vailatis/mqtt_thermostat/sample_pictures/2_Mode.jpg

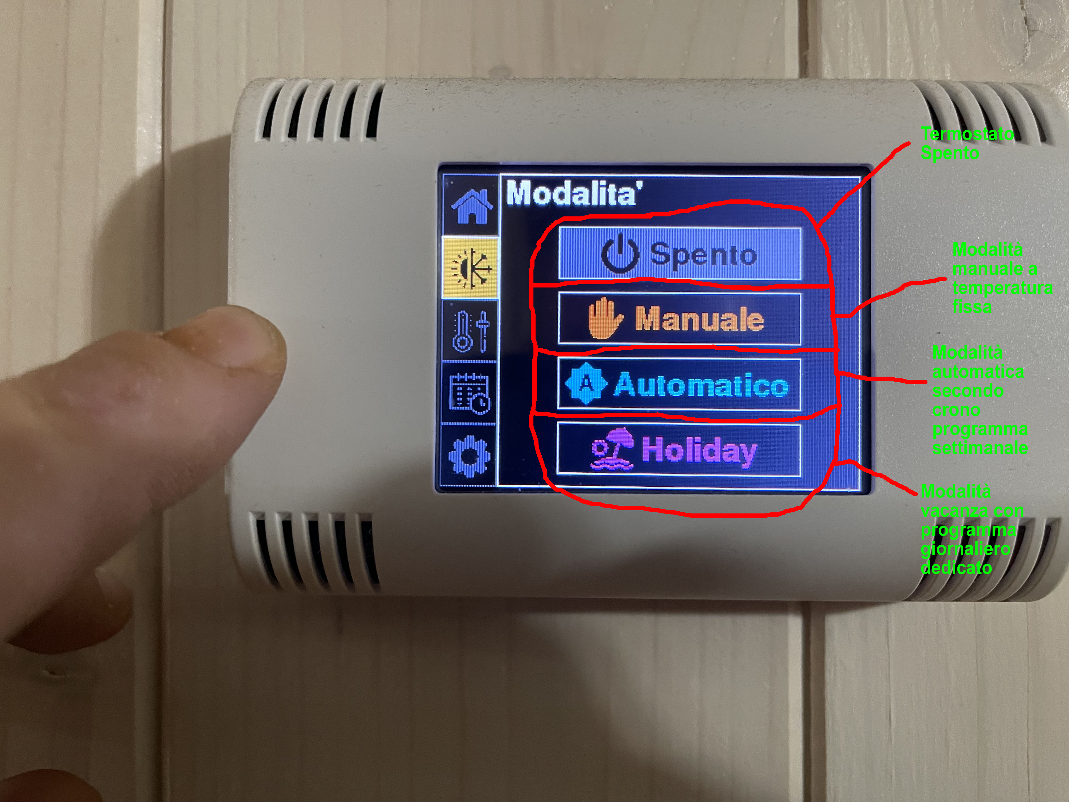
sample_pictures/2_Mode.jpg
