vailatis/mqtt_thermostat/sample_pictures/3_SetPoints.jpg

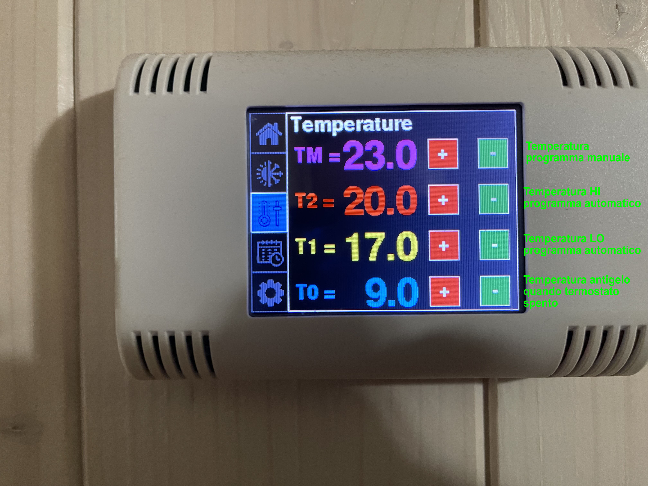
sample_pictures/3_SetPoints.jpg
