vailatis/mqtt_thermostat/sample_pictures/4_Schedule.jpg

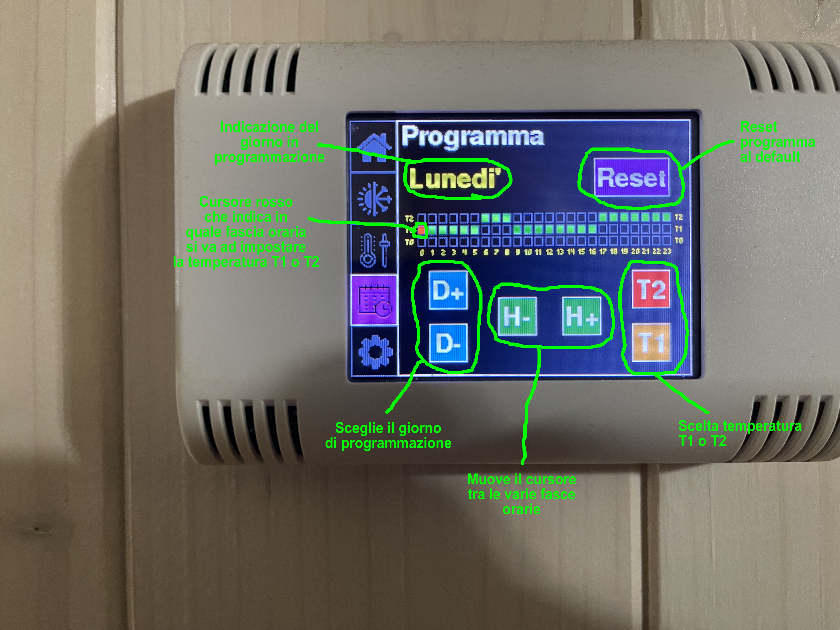
sample_pictures/4_Schedule.jpg
