vailatis/mqtt_thermostat/sample_pictures/5_Settings.jpg

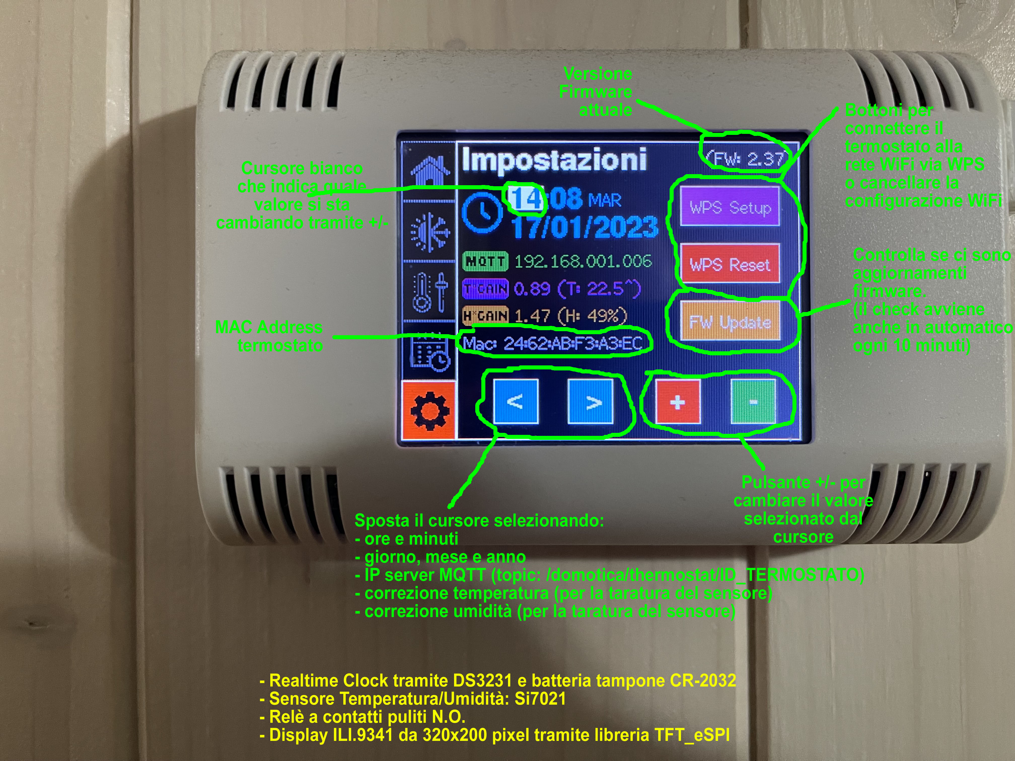
sample_pictures/5_Settings.jpg
