vailatis/mqtt_thermostat/sample_pictures/CS_Frontale.jpg

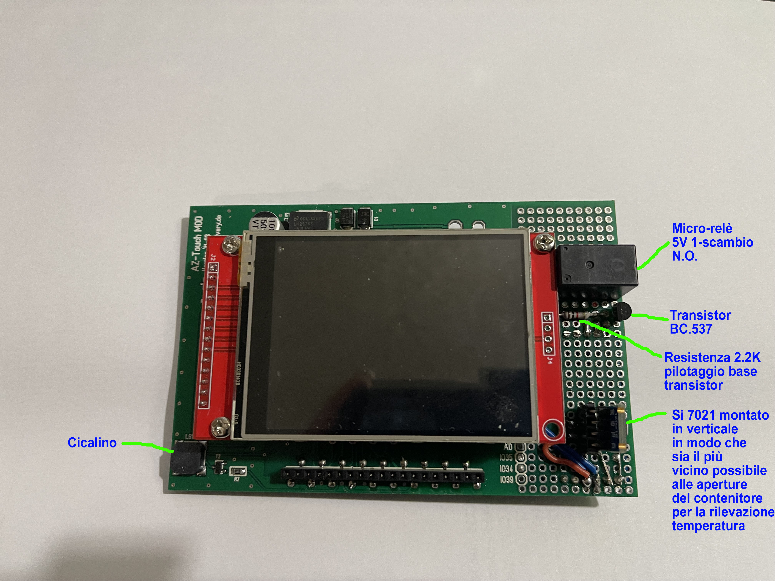
sample_pictures/CS_Frontale.jpg
