vailatis/mqtt_thermostat/sample_pictures/CS_Posteriore.jpg

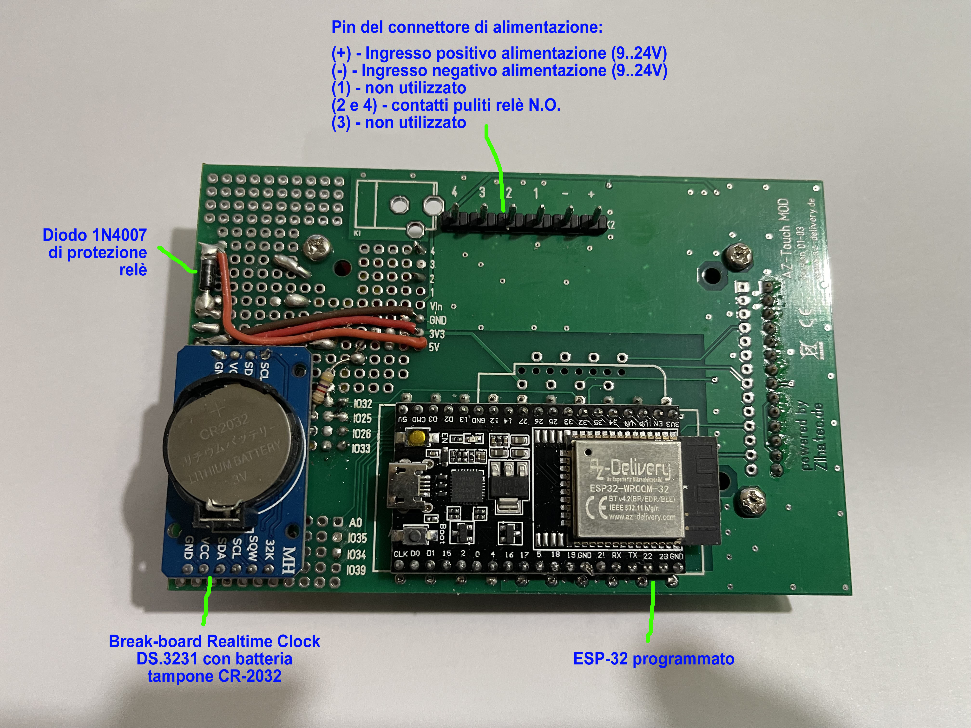
sample_pictures/CS_Posteriore.jpg
