vailatis/mqtt_thermostat/AZ-Touch MOD schematic V01-03-01 (1).pdf

K6 | TFT 2.4 inch / 240x320 GPIO25 GPIO33 GPIO32 GPIO35 GPIO34 GPIO39 A0GPIO26 GND GPIO26 GPIO25 GPIO33 GPIO32 GPIO35 GPIO34 GPIO39

## TxD

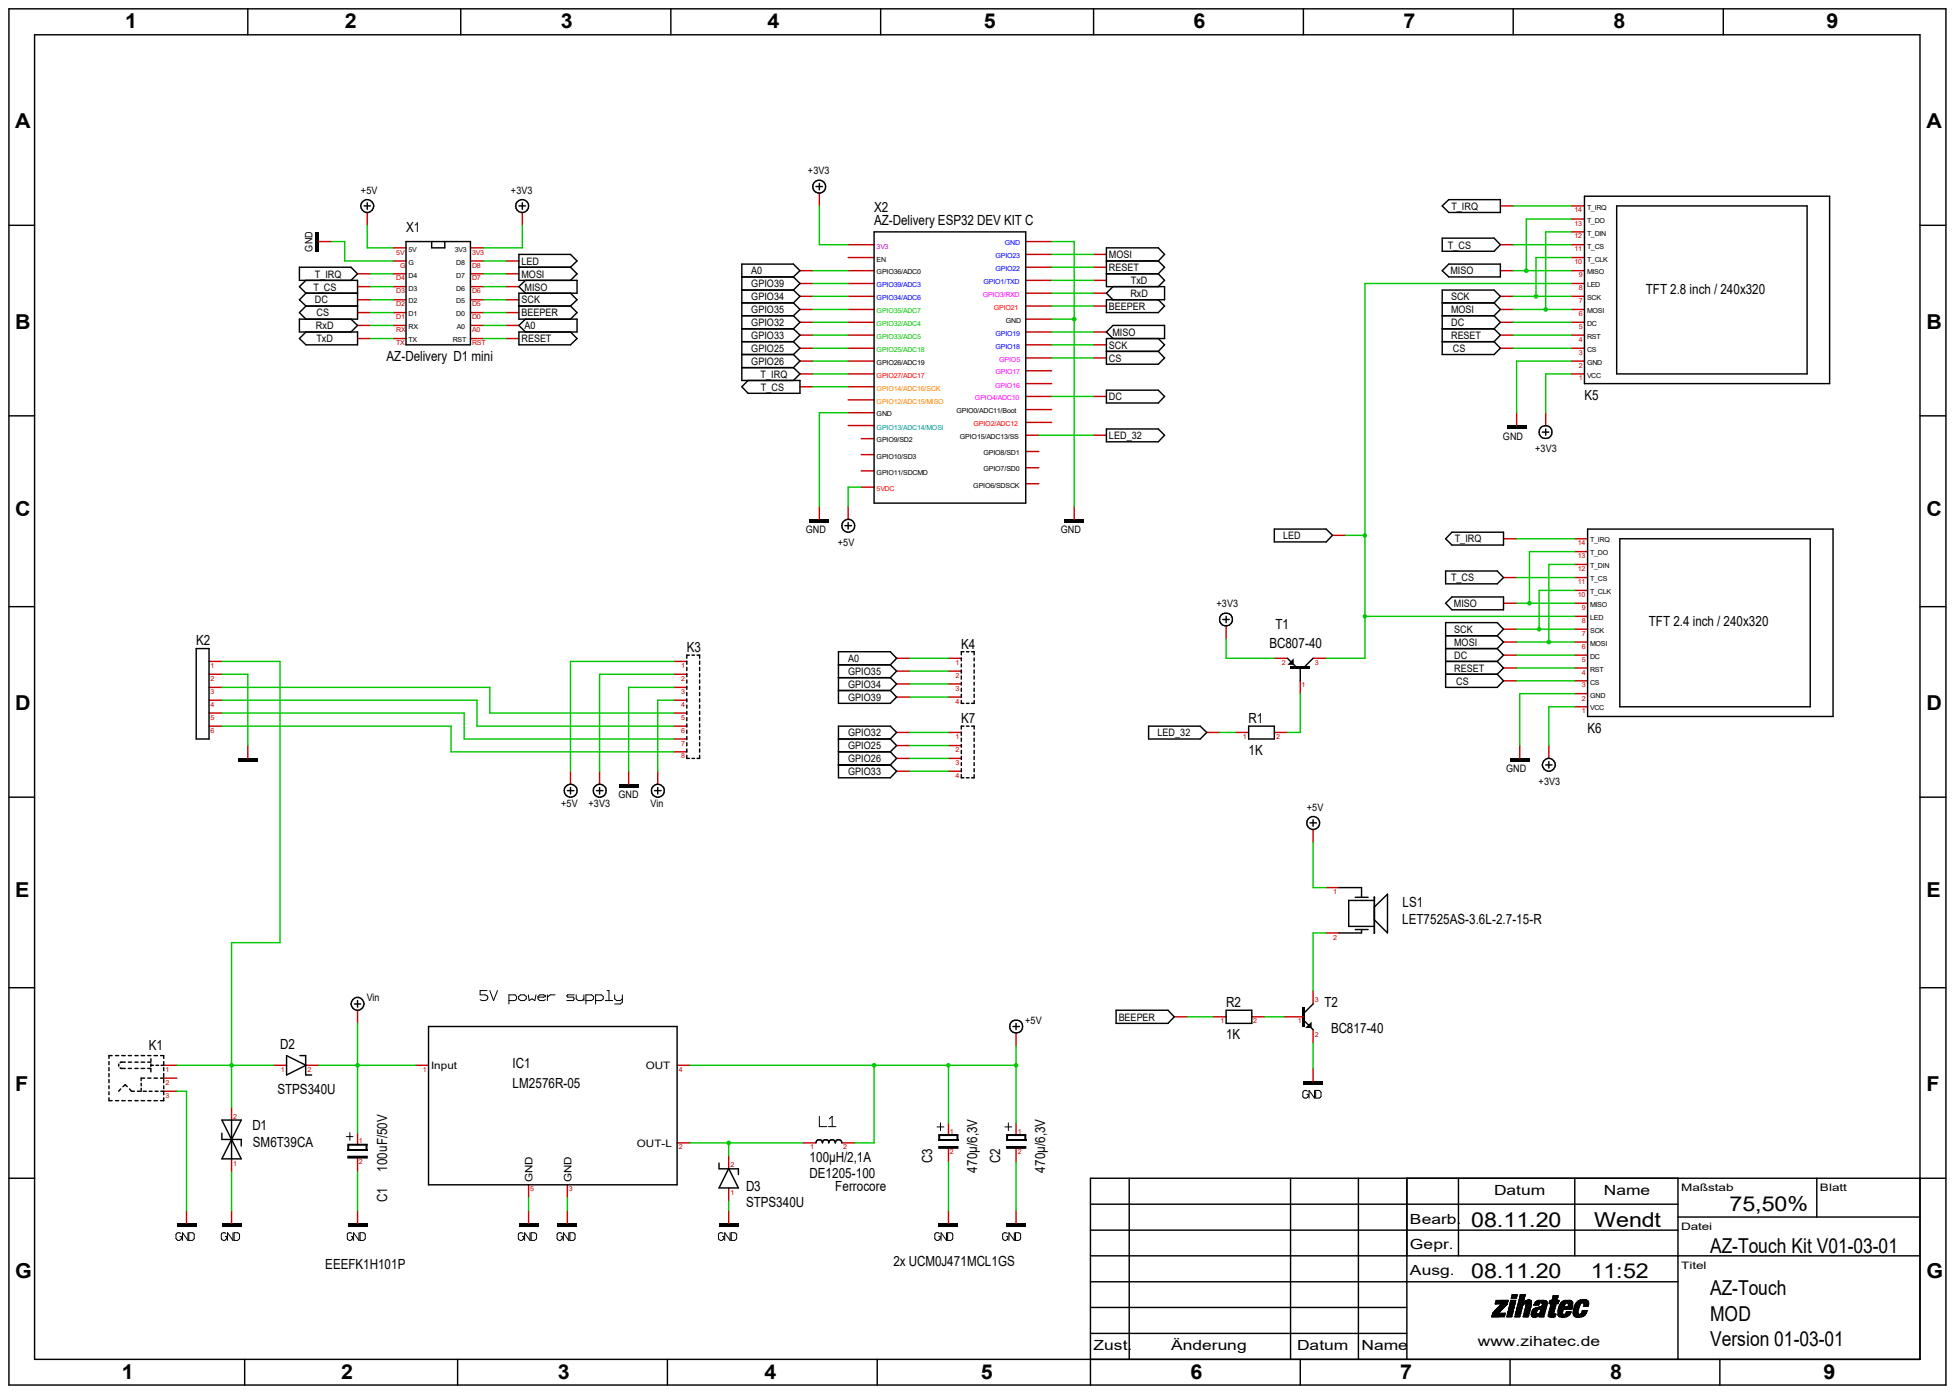
[picture p10: page 1]

3V3 AZ-Delivery ESP32 DEV KIT C X2
SCK MISO MOSI GND
