vailatis/mqtt_thermostat/firmware/graphics.h

// #####################
// ### GRAPHIC ICONS ###
// #####################

// ##############################
// ### ICONS SIZE DEFINITIONS ###
// ##############################
const unsigned int ICONS_Size = 32;
const unsigned int ICONS16_Size = 16;

// #########################
// ### DISPLAY TAB ICONS ###
// #########################
const unsigned char ICON_Tab_Home [] PROGMEM = {
   0x00, 0x00, 0x00, 0x00, 0x00, 0x00, 0x00, 0x00, 0x00, 0x00, 0x00, 0x00, 0x00, 0x01, 0x81, 0xe0, 
   0x00, 0x03, 0xc3, 0xe0, 0x00, 0x0f, 0xf3, 0xe0, 0x00, 0x1f, 0xfb, 0xe0, 0x00, 0x3e, 0x7f, 0xe0, 
   0x00, 0x7c, 0x3f, 0xe0, 0x00, 0xf9, 0x9f, 0xe0, 0x03, 0xe7, 0xe7, 0xe0, 0x07, 0xcf, 0xf3, 0xe0, 
   0x0f, 0x9f, 0xf9, 0xf0, 0x1f, 0x3f, 0xfc, 0xf8, 0x3e, 0x7f, 0xfe, 0x7c, 0xf9, 0xff, 0xff, 0x9f, 
   0xf3, 0xff, 0xff, 0xcf, 0x67, 0xff, 0xff, 0xe6, 0x07, 0xff, 0xff, 0xe0, 0x07, 0xff, 0xff, 0xe0, 
   0x07, 0xff, 0xff, 0xe0, 0x07, 0xfc, 0x3f, 0xe0, 0x07, 0xf8, 0x1f, 0xe0, 0x07, 0xf8, 0x1f, 0xe0, 
   0x07, 0xf8, 0x1f, 0xe0, 0x07, 0xf8, 0x1f, 0xe0, 0x07, 0xf8, 0x1f, 0xe0, 0x07, 0xf8, 0x1f, 0xe0, 
   0x07, 0xf8, 0x1f, 0xe0, 0x00, 0x00, 0x00, 0x00, 0x00, 0x00, 0x00, 0x00, 0x00, 0x00, 0x00, 0x00
};
const unsigned char ICON_Tab_Mode [] PROGMEM = {
   0x00, 0x01, 0x80, 0x00, 0x00, 0x21, 0x80, 0x00, 0x00, 0x31, 0xe0, 0x00, 0x00, 0x31, 0xe0, 0x00, 
   0x00, 0x31, 0x81, 0x80, 0x06, 0x11, 0x81, 0xe0, 0x07, 0x01, 0x81, 0xe0, 0x03, 0x09, 0x81, 0xf0, 
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
   0x49, 0x88, 0x99, 0xf8, 0x66, 0x49, 0xc8, 0x99, 0xf8, 0x66, 0x49, 0xc8, 0xff, 0xff, 0xff, 0xff, 
   0xf8, 0xff, 0xff, 0xff, 0xff, 0xf8, 0x7f, 0xff, 0xff, 0xff, 0xf0, 0x3f, 0xff, 0xff, 0xff, 0xe0
};
const unsigned char ICON16_Humidity [] PROGMEM = {      // 16x16 pixels
   0x01, 0x80, 0x01, 0x80, 0x03, 0xc0, 0x07, 0xe0, 0x07, 0xe0, 0x0f, 0xf0, 0x1d, 0xf8, 0x1a, 0xd8, 
   0x3d, 0xbc, 0x3f, 0x7c, 0x3e, 0xfc, 0x3d, 0xbc, 0x1b, 0x58, 0x1f, 0xb8, 0x0f, 0xf0, 0x03, 0xc0
};
const unsigned char ICON16_SetPoint [] PROGMEM = {      // 16x16 pixels
   0x00, 0xc0, 0x01, 0x20, 0x11, 0x20, 0x19, 0x20, 0x1d, 0xe0, 0x19, 0xe0, 0x11, 0xe0, 0x01, 0xe0, 
   0x01, 0xe0, 0x03, 0xf0, 0x07, 0xf8, 0x07, 0xf8, 0x07, 0xf8, 0x07, 0xf8, 0x03, 0xf0, 0x01, 0xe0
};
